stleraburg/Robotiq-Gripper-Coupling-for-Franka-Emika/closerView.jpg

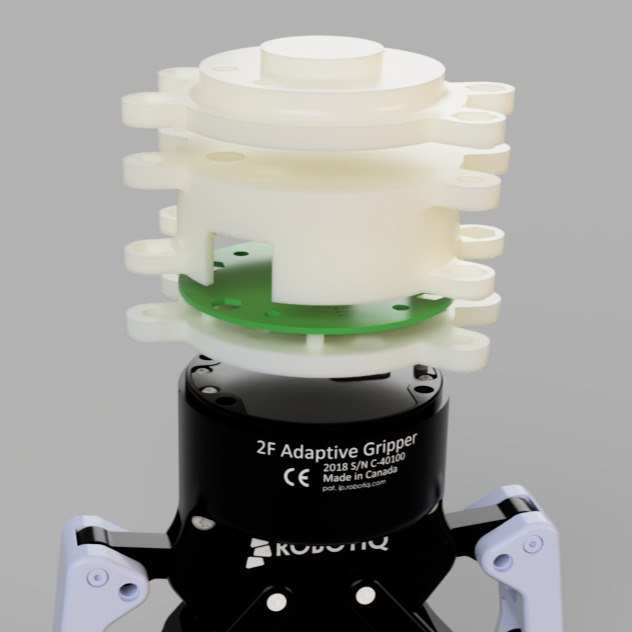
closerView.jpg
