stleraburg/Robotiq-Gripper-Coupling-for-Franka-Emika/photo_5328064848501792893_y.jpeg

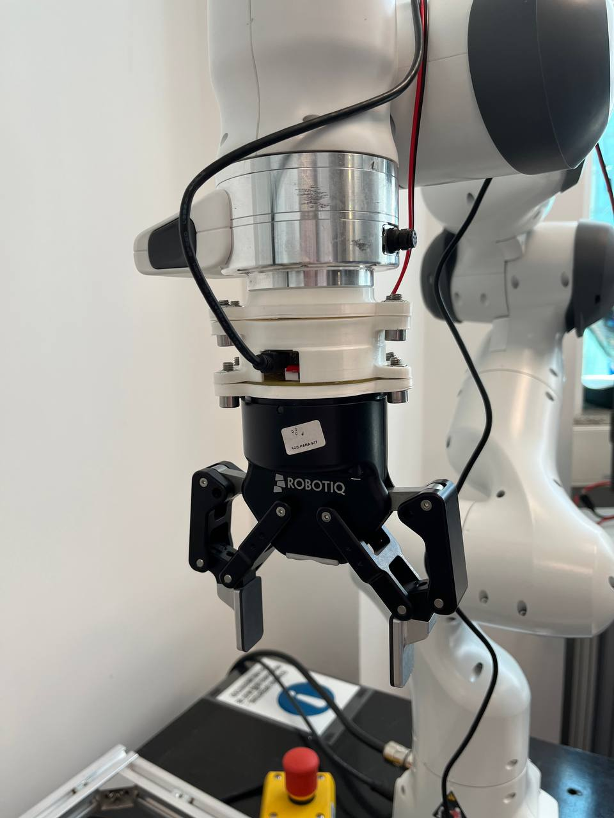
photo_5328064848501792893_y.jpeg
