stleraburg/Robotiq-Gripper-Coupling-for-Franka-Emika/sideView.jpeg

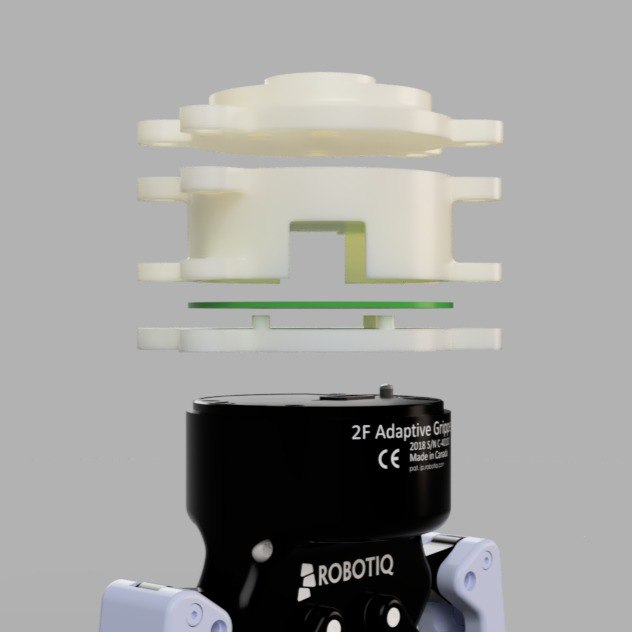
sideView.jpeg
