stleraburg/Robotiq-Gripper-Coupling-for-Franka-Emika/stl_files/PCBcoupling.stl

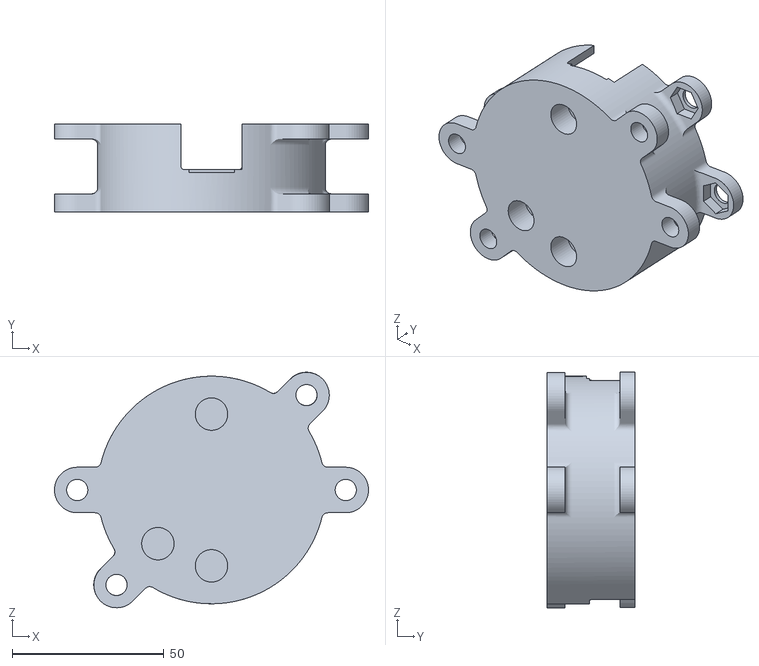
[picture p7: CAD file, 2024-05-10]
stl_files/PCBcoupling.stl
103.5 x 29.0 x 77.6
