stleraburg/Robotiq-Gripper-Coupling-for-Franka-Emika/stl_files/gripper adapter.stl

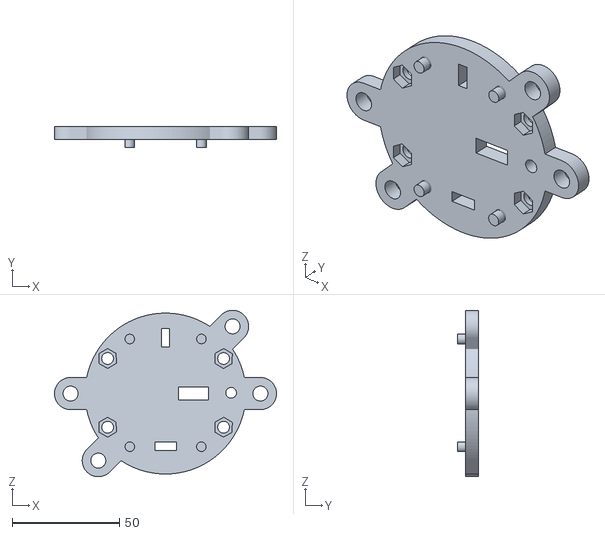
[picture p8: CAD file, 2024-05-10]
stl_files/gripper adapter.stl
103.5 x 9.70 x 77.5
