stleraburg/Robotiq-Gripper-Coupling-for-Franka-Emika/stl_files/Franka adapter.stl

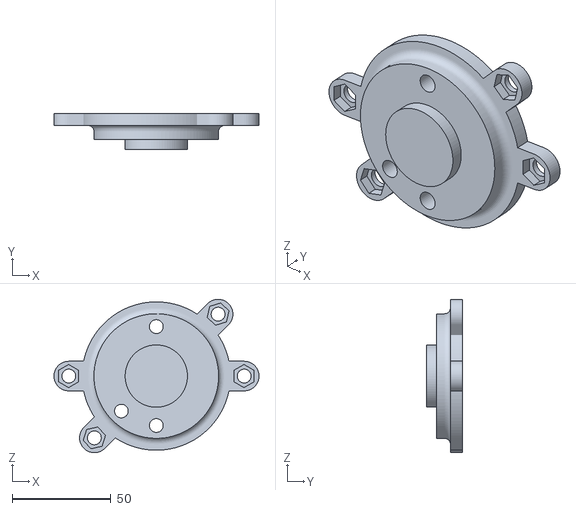
[picture p9: CAD file, 2024-05-10]
stl_files/Franka adapter.stl
103.7 x 18.0 x 77.5
