stleraburg/Robotiq-Gripper-Coupling-for-Franka-Emika/KiCad_files/gripperRobotiq_adapter.kicad_pcb

## KiCad design KiCad_files/gripperRobotiq_adapter.kicad_pcb (2024-05-11)

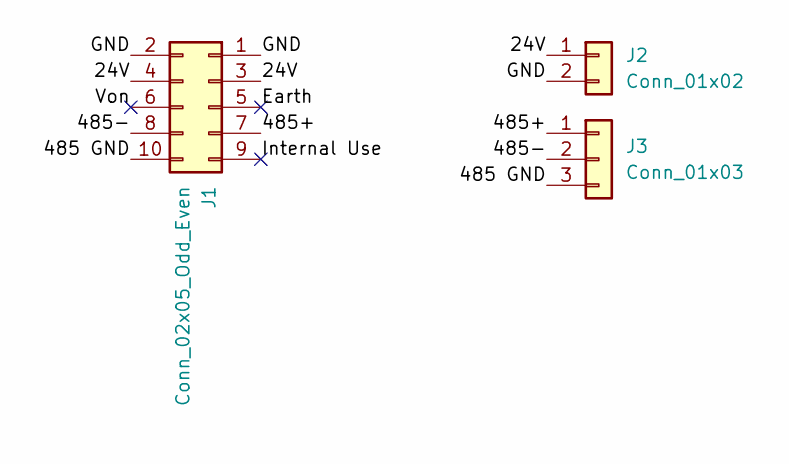
[picture p10: schematic gripperRobotiq_adapter.kicad_sch]

Parts:
J1: Conn_02x05_Odd_Even; PinHeader_2x05_P2.54mm_Vertical
J2: Conn_01x02; TerminalBlock_Phoenix_PT-1,5-2-5.0-H_1x02_P5.00mm_Horizontal
J3: Conn_01x03; PinHeader_1x03_P2.54mm_Vertical

Connections:
/24V: J1.3, J1.4, J2.1
/485 GND: J1.10, J3.3
/485+: J1.7, J3.1
/485-: J1.8, J3.2
/Earth: J1.5
/GND: J1.1, J1.2, J2.2
/Internal Use: J1.9
/Von: J1.6

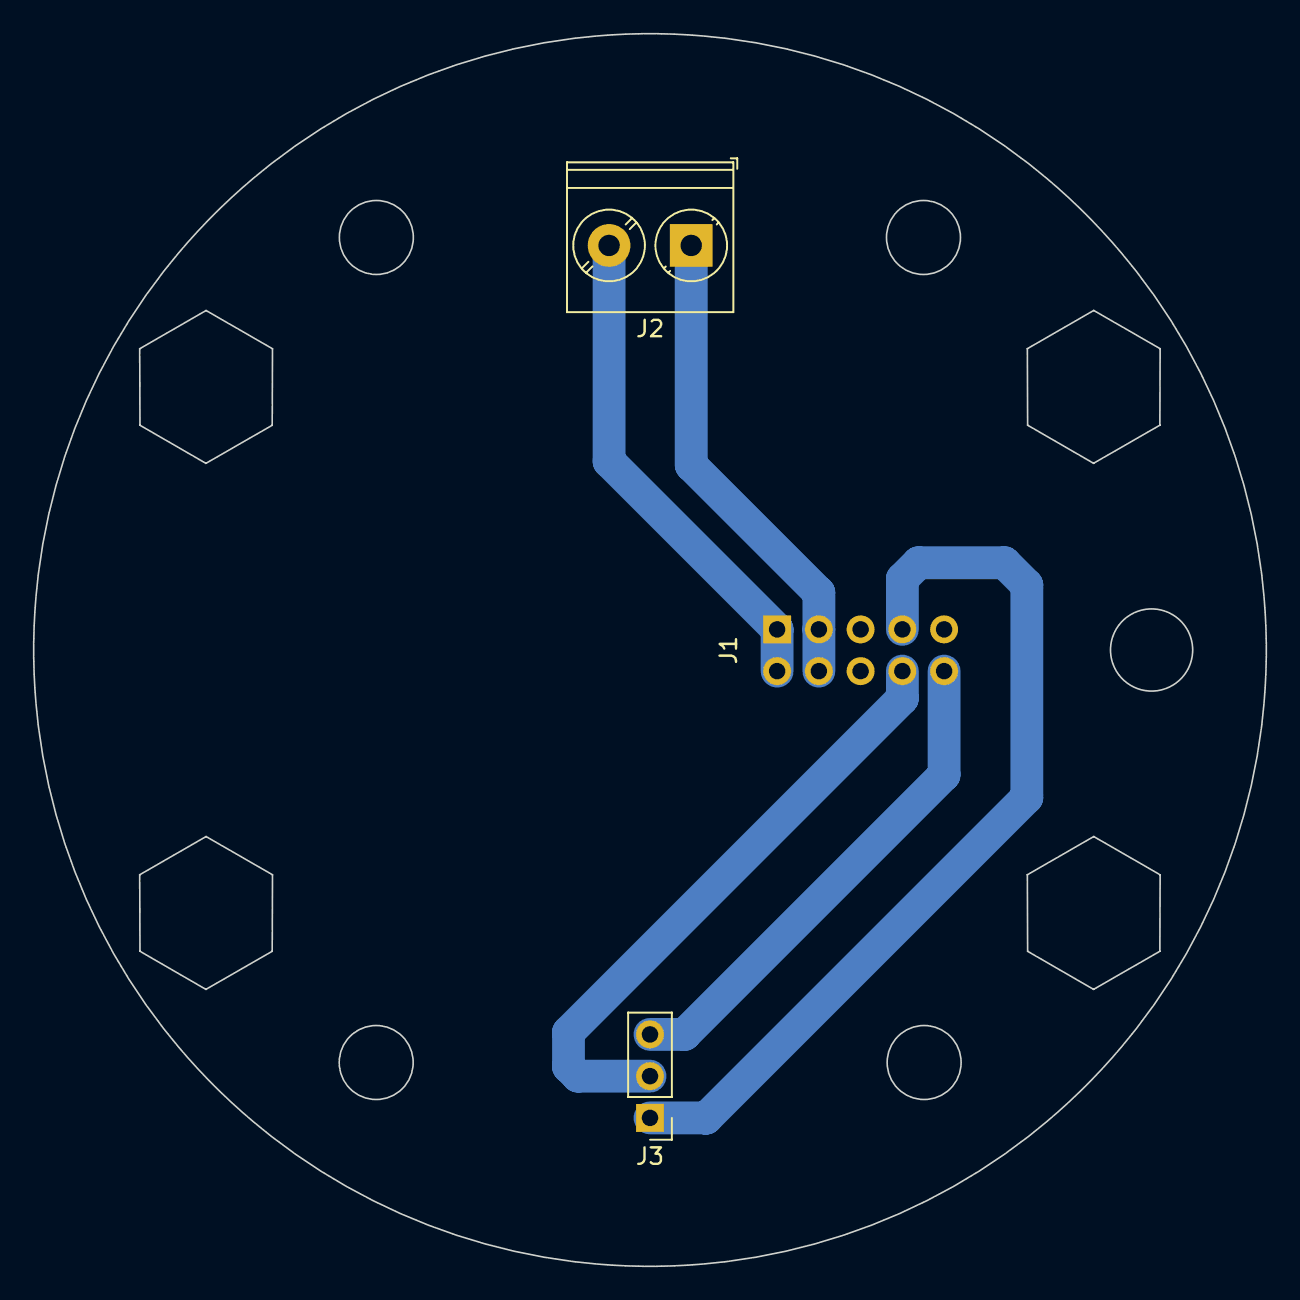
[picture p11: board gripperRobotiq_adapter.kicad_pcb from above]

Board: 2 copper layers, 75.0 x 75.0 mm, 3 parts (1 on the bottom side), 5 nets.
