stleraburg/Robotiq-Gripper-Coupling-for-Franka-Emika/(commit log)

2024-05-10 add stl files
    [Franka adapter.stl, PCBcoupling.stl, gripper adapter.stl]
2024-05-11 push PCB files
    [Franka adapter.stl, PCBcoupling.stl, gripper adapter.stl]
